abda-s/FSUK-BMS/(list of files, cad)

Other CAD files:
Reference Docs/Community Board Examples/Olin College FSAE - Tractive System Active Light Board.step
Reference Docs/Shared/Community Board Examples/Olin College FSAE - AIL Precharge Board.step
Reference Docs/Community Board Examples/Olin College FSAE - Master Switch Panel Monitor Board.step
