abda-s/FSUK-BMS/BMS-Master/sim/buck/buck_startup.asc

Cb: cap; 100u; Rser=0.3
Cboot: cap; 100n
Cff: cap; 6.8p
Cin: cap; 12u; Rser=3m
Cinx: cap; 100n
Cout: cap; 26u; Rser=3m
Css: cap; 33n
L1: ind; 8.2u; Rser=83m
Lh: ind; 1u
Renb: res; 86.6k
Rent: res; 511k
Rfbb: res; 10k
Rfbt: res; 71.5k
Rh: res; 50m
Rload: res; 6.5
U1: TPS62933F
V1: voltage; PWL(0 0 1m 12)
Named nets: vbat, vin, en, ss, bst, sw, vout, fb, 0
RT open = 500 kHz
12 V battery
Lh, Rh = ~1 m harness (not on PCB)
2x 10uF 50V = ~12uF at 12 V
UVLO 8.0 V on / 7.0 V off
ANR5040T8R2M
47uF 16V = ~26uF at 6.5 V
Vout = 0.8 x (1 + 71.5k/10k) = 6.52 V
TPS62933F buck: 12 V -> 6.5 V, start-up with a 1 A load.  Values = LCSC BOM.csv
.include TPS62933F_LTspice.lib
.options reltol=0.005 trtol=7 method=gear
.save V(vout) V(vin) V(sw) V(ss) V(en) V(bst) V(fb) I(L1) I(Rh)
.tran 0 9m 0 20n
.meas tran t_on WHEN V(vout)=0.1 RISE=1
.meas tran vin_on FIND V(vin) AT=t_on
.meas tran t_90 WHEN V(vout)=5.87 RISE=1
.meas tran vout_max MAX V(vout)
.meas tran il_max MAX I(L1)
.meas tran vout_avg AVG V(vout) FROM 8m TO 9m
.meas tran vout_pp PP V(vout) FROM 8.5m TO 9m
.meas tran il_pp PP I(L1) FROM 8.5m TO 9m
.meas tran pin AVG V(vin)*I(Rh) FROM 8m TO 9m
.meas tran pout AVG V(vout)*V(vout)/6.5 FROM 8m TO 9m
.meas tran eff PARAM pout/pin
