abda-s/FSUK-BMS/(list of files, drawings)

Other design files:
BMS-Master/BMS-Master.PrjPcb
BMS-Master/Sheets/AMS_SDC.SchDoc
BMS-Master/Sheets/CAN.SchDoc
BMS-Master/Sheets/Charger.SchDoc
BMS-Master/Sheets/Connectors.SchDoc
BMS-Master/Sheets/Current_Sense.SchDoc
BMS-Master/Sheets/MCU_STM32.SchDoc
BMS-Master/Sheets/Power.SchDoc
BMS-Master/Sheets/Stack_Interface.SchDoc
BMS-Master/Sheets/Top.SchDoc
BMS-Module/BMS-Module.PrjPcb
BMS-Module/PCB1.PcbDoc
BMS-Module/Sheets/AFE_BQ79616.SchDoc
BMS-Module/Sheets/Balancing.SchDoc
BMS-Module/Sheets/Cell_Sense.SchDoc
BMS-Module/Sheets/Connectors.SchDoc
BMS-Module/Sheets/DaisyChain_Comm.SchDoc
BMS-Module/Sheets/Thermistor_Mux.SchDoc
BMS-Module/Sheets/Top.SchDoc
Reference Docs/BQ796xx BMS/TIDA-010271 Reference Design/TIDA-010271 Altium Source (tidmc07)/BMU0912_Hardware.SchDoc
Reference Docs/BQ796xx BMS/TIDA-010271 Reference Design/TIDA-010271 Altium Source (tidmc07)/BMU_A1_Cell_Network.SchDoc
Reference Docs/BQ796xx BMS/TIDA-010271 Reference Design/TIDA-010271 Altium Source (tidmc07)/BMU_A2_bq79616.SchDoc
Reference Docs/BQ796xx BMS/TIDA-010271 Reference Design/TIDA-010271 Altium Source (tidmc07)/BMU_A2_Cell_Network.SchDoc
Reference Docs/BQ796xx BMS/TIDA-010271 Reference Design/TIDA-010271 Altium Source (tidmc07)/BMU_BQ79616.PcbDoc
Reference Docs/BQ796xx BMS/TIDA-010271 Reference Design/TIDA-010271 Altium Source (tidmc07)/Cap_BMS_Communications.SchDoc
Reference Docs/BQ796xx BMS/TIDA-010271 Reference Design/TIDA-010271 Altium Source (tidmc07)/conn_705550048.PcbLib
Reference Docs/BQ796xx BMS/TIDA-010271 Reference Design/TIDA-010271 Altium Source (tidmc07)/conn_705550048.SchLib
Reference Docs/BQ796xx BMS/TIDA-010271 Reference Design/TIDA-010271 Altium Source (tidmc07)/V2_lib.SchLib
Reference Docs/Master/Power/TPS62933F PSpice Model (SLUM859)/TPS62933F_PSPICE_TRANS/TPS62933F_TRANS.opj
Reference Docs/Master/Power/TPS62933F PSpice Model (SLUM859)/TPS62933F_PSPICE_TRANS/TPS62933FDRL_TRANS.OLB
Reference Docs/Module/TIDA-010271 Reference Design/TIDA-010271 Altium Source (tidmc07)/BMU_A1_bq79616.SchDoc
Reference Docs/Module/TIDA-010271 Reference Design/TIDA-010271 Altium Source (tidmc07)/BMU_BQ79616_coversheet.SchDoc
Reference Docs/Module/TIDA-010271 Reference Design/TIDA-010271 Altium Source (tidmc07)/BMU_EVCC_20230723.PrjPcb
Reference Docs/Module/TIDA-010271 Reference Design/TIDA-010271 Altium Source (tidmc07)/Cell_Simulator.SchDoc
Reference Docs/Module/TIDA-010271 Reference Design/TIDA-010271 Altium Source (tidmc07)/Transf_BMS_Communications.SchDoc
Reference Docs/Module/TIDA-010271 Reference Design/TIDA-010271 Altium Source (tidmc07)/V2_Lib.PcbLib
Reference Docs/Power/TPS62933F PSpice Model (SLUM859)/TPS62933F_PSPICE_TRANS/TPS62933F_TRANS.DSN
