abda-s/FSUK-BMS/(commit log)

2026-09-26 changed the settings to make sure that the Ports will name the nets
    [BMS-Master.PrjPcb]
2026-09-26 Initial commit: BMS-Master and BMS-Module Altium projects + reference docs
    [AFE_BQ79616.SchDoc, BMS-Master.PrjPcb, BMS-Module.PrjPcb, Balancing.SchDoc, CAN.SchDoc, Cell_Sense.SchDoc, Connectors.SchDoc, Current_Sense.SchDoc]
2026-10-01 Add TIDA-010271 Altium reference design source (tidmc07)
    [BMU0912_Hardware.SchDoc, BMU_A1_Cell_Network.SchDoc, BMU_A1_bq79616.SchDoc, BMU_A2_Cell_Network.SchDoc, BMU_A2_bq79616.SchDoc, BMU_BQ79616.PcbDoc, BMU_BQ79616_coversheet.SchDoc, BMU_EVCC_20230723.PrjPcb]
2026-10-02 Organize randoms folder: sort academic papers vs community board examples, annotate links.txt as links.md
2026-10-02 Track images via LFS; add gitignored Open-Source BMS Projects reference folder
2026-10-02 Add Olin College FSAE support-board exports; document 6 more open-source BMS reference repos
    [Olin College FSAE - AIL Precharge Board.step, Olin College FSAE - Master Switch Panel Monitor Board.step, Olin College FSAE - Tractive System Active Light Board.step]
2026-10-02 test file
    [Top.SchDoc]
2026-10-02 added the MCU, this is just for testing git shit
    [MCU_STM32.SchDoc]
2026-10-02 added "Text" in Top
    [Top.SchDoc]
2026-10-02 testing the lfs lock shit
    [CAN.SchDoc, MCU_STM32.SchDoc, Power.SchDoc]
2026-10-02 Add OutputJob files for one-click schematic PDF export, modeled on TI's reference design
    [BMS-Master.PrjPcb, BMS-Module.PrjPcb]
2026-10-02 Generate BMS-Master schematic PDF via OutputJob
    [BMS-Master.PrjPcb]
2026-10-02 added the job that generates the PDF schematic files
    [BMS-Module.PrjPcb]
2026-10-02 added text
    [Top.SchDoc]
2026-10-02 Add STM32G474 MCU selection rationale and block diagram for BMS-Master
2026-10-02 Consolidate design docs into per-board README.md, fix dangling chat-history citation
2026-10-02 Trim narrative padding from BMS-Master README, keep it factual
2026-10-03 Added the STM32G474REV with the capacitors and the crystal
    [MCU_STM32.SchDoc]
2026-10-03 Organize STM32G474 datasheet into Reference Docs, link from MCU selection doc
2026-10-03 Added the basic setup for the BQ79600, we still need to do the diff pair isolation
    [Stack_Interface.SchDoc]
2026-10-03 updated the schematic pdf
2026-10-05 sch(master): Add the final power and conf pins schematics MCU_STM32.SchDoc
    [MCU_STM32.SchDoc]
2026-10-05 docs(master): updated the schematics PDF
2026-10-06 docs(master): drop standby-current and ESD as CAN transceiver requirements
2026-10-06 docs(master): confirm Hall-effect current sensor, drop op-amp as MCU factor
2026-10-06 docs(master): clarify ADC requirement drives current limit/fault logic, not just telemetry
2026-10-06 docs(master): CAN transceiver v1=TCAN1042V-Q1 (stock/hand-solder), v2 target=TCAN1462V-Q1
2026-10-06 sch(master): finish the initial design of the CAN CAN.SchDoc
    [CAN.SchDoc, Top.SchDoc]
2026-10-06 doc(master): update the schematic PDF
2026-10-06 ref: organize LEM DHAB S124 current sensor datasheet; link from MCU selection sources
2026-10-07 fix(master): fix resistor values CAN.SchDoc
    [CAN.SchDoc, Top.SchDoc]
2026-10-08 fix(master): fixed the CAN shit CAN.SchDoc
    [CAN.SchDoc]
2026-10-08 sch(master): Add the isolation part to the COM ports Stack_Interface.SchDoc
    [Stack_Interface.SchDoc]
2026-10-08 fix(master): idk maybe changed some settings
    [BMS-Master.PrjPcb]
2026-10-09 fix(master): Add some new notes that needs to be implemented
    [CAN.SchDoc]
2026-10-09 sch(master): Add some notes to how to do the isolation correctly cuz now it's not isolated
    [Stack_Interface.SchDoc]
2026-10-14 docs(master): add daisy-chain transformer selection (SM91502ALE)
    - Document transformer choice against TI SLVAEP4 validated list and
    FSG EV 1.2.1 / EV 4.3.6, comparing SM91502AL, HMU1228NL, HM2147NL.
    - ref: organize BMS transformer (Bourns SM91502AL, Pulse HMU1228NL,
    Pulse BM101, CND-tek CB0603S), Bourns SRF0703 choke and TDSEMI
    PESD5V0L2BT ESD datasheets.
2026-10-15 ref(master): Add datasheets for current sensors
2026-10-15 ref: upload high voltage cables datasheet
2026-10-15 sch(module): add balancing and daisy-chain circuits
    Balancing.SchDoc and DaisyChain_Comm.SchDoc, with the matching
    hookup in AFE_BQ79616.SchDoc.
2026-10-15 sch(module): add cell-sense input filters to Cell_Sense.SchDoc
    Work in progress - filter values not final.
2026-10-15 pcb(module): add PCB1.PcbDoc and register new docs in project
    Also adds Choke.SCHLIB to the project, saves the SMW0530H library
    update settings and drops unused export outputs.
2026-10-15 docs(master): add current sensor selection (DHAB S/124)
    - Document DHAB S/124 against FSG/FSUK rules (EV 5.8, T 11.9, EV 1.2.1),
    how it works, ADC interface, fault detection, accuracy, isolation via
    the 600 V cable insulation, mounting, alternatives and open items.
    - Add explanatory SVG diagrams under BMS-Master/docs/current-sensor/.
    - ref: move TS cable datasheet to Reference Docs/TS Cable/.
2026-10-15 sch(master): add DHAB S/124 current sense front end Current_Sense.SchDoc
    - 12k/18k 0.1% dividers + 100 nF ADC caps for HI, LO and sensor supply.
    - 22 nF C_L on HI/LO (DHAB datasheet: 1-100 nF output load), 47 nF on +5.
    - Harnesses ISENSE_SENSOR (HI, LO) and ISENSE_ADC (HI, LO, SUPPLY);
    nets renamed to ISENSE_* convention.
    - Design notes on the sheet explaining each block and PCB placement.
2026-10-15 ref: highlight 300 V UL rating in DHAB S/124 datasheet
    Marks the "primary involved potential 300 V" line that the isolation
    argument in BMS-Master/README.md addresses.
2026-10-17 sch(master): add isolated charger STOP interface Charger.SchDoc
    PC817 opto drives the Manzanita Reg Bus BLACK line, fail-safe (10k
    pull-up stops the charger unless CHG_EN is high). Nets renamed to
    CHG_EN, REGBUS_STOP, +5V_REGBUS, GND_REGBUS, with short notes.
    README: charger interface section; RJ12 jack must be ordered online.
    Adds PC817 datasheet and the charger owner's manual.
2026-10-17 sch(master): add AMS_OK 12 V output to the SDC AMS_SDC.SchDoc
    Two-MOSFET high-side driver (AO3400A level shift, AO3401A switch)
    gives 12 V on AMS_OK while the MCU says OK and 0 V on fault, reset,
    power loss, broken wire or short. Drives the SDC board relay coil
    (G5Q-14-DC12) through a 100 mA PTC; no series resistor.
    README: AMS_OK section with resistor calculations and sources,
    external watchdog moved to v2, IWDG firmware item.
    Adds MOSFET, relay, fuse and watchdog datasheets and app notes.
2026-10-17 sch(master): transformer same-part note, update block diagram
    Stack_Interface.SchDoc: note that the transformer must be the same part
    number as on BMS-Module (TI BQ79600 requirement). Updated block diagram.
2026-10-17 docs(master): update to-do, AMS_OK and isolation notes
    - AMS_OK also opens the charging SDC; schematic image replaces the
    text drawing; flyback diode and RT2 notes removed
    - Charger opto PC817B checked against EV 1.2.1 (passes, kept) and
    EV 4.3.6 creepage note
    - Transformer insulation grades explained (Functional vs Basic) and
    what to ask FSUK before ordering
    - To-do: Top.SchDoc, charger opto and transformer note done
2026-10-18 sch(master): add balancing master switch MCU_STM32.SchDoc
    ALPS SSSS811101 slide switch: common to GND, pin 3 to BAL_EN_N with a
    10k pull-up to 3V3 and 100 nF to GND. Active low, so off, reset or a
    failed joint all read as balancing off.
    README: balancing switch section (what it does, why each part), to-do
    updated. Adds the switch datasheet.
2026-10-21 docs(master): power budget, TPS62933F buck design and LTspice start-up sim
    Power tree and budget, buck BOM and UVLO, LTspice model patches, schematic,
    results and charts. Large sim outputs (.raw, data CSV, chart gallery) are
    gitignored.
2026-10-21 sch(master): rename +5 to +5V, AMS_OK 2K2 output resistor
2026-10-21 docs: add power reference docs (TPS6293x, LMR51430, SMBJ16A, WEBENCH, TI model), BSS84
2026-10-21 sch(master): TPS62933F 12 V to 6 V buck on Power.SchDoc
2026-10-22 docs(master): add buck schematic image from Power.SchDoc
2026-10-22 docs(master): 6.5 V buck, LDO selection, LV input protection, full buck sims
    - Buck raised to 6.52 V (R_FBT 71.5k) so the 5 V LDO gets the 1.5 V
    headroom its datasheet specs assume; power budget recomputed.
    - LDO selection: TI TLV76150DCYR / TLV76133DCYR (SOT-223), with the
    requirements, all 16 candidates and why each was rejected, PSRR explainer.
    - LV input protection: 1 A slow-blow fuse, SS34 reverse diode, SMBJ16A TVS.
    - Simulations: load step, 9/11/16 V input, hot-plug with/without bulk cap
    and TVS; 9 V loop oscillation found, fixed by a second 47 uF in sim.
    - Charts regenerated; Altium images for buck, LDOs and input protection.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
2026-10-22 sch(master): input protection, 6.5 V buck and TLV761 LDOs on Power.SchDoc
2026-10-22 docs: LDO candidate datasheets; buck BOM R_FBT 71.5k
2026-10-22 docs(master): regenerate schematic PDF, one page per sheet
    OutJob: FitSCHPrintSizeToDoc=1 so each PDF page takes its sheet's size.
    Before, every sheet was printed 1:1 onto A4 and the larger sheets (CAN)
    were tiled across two pages. Now 9 sheets = 9 pages.
2026-10-23 sch(master): connectors J1-J4, CAN as one reused channel, MCU ports, Top wired
    - Connectors.SchDoc: J1 Micro-Fit 2x8, J2 Micro-Fit 2-pin (COMH), J3 RJ12
    DS1133-S60BPX, J4 SWD; pins wired to ports, SWD as a harness
    - CAN.SchDoc: single TCAN1042 channel placed twice on Top (CAN1, CAN2);
    bus side as plain CAN_H/CAN_L ports, MCU side CAN_MCU harness
    - Top.SchDoc: sheet symbols named, Charger/AMS_SDC file names fixed,
    all sheets wired including CONN and MCU
    - MCU_STM32.SchDoc: ports and harnesses for every Top link (pins not
    assigned yet)
    - README: connector parts and photos, schematic structure section,
    STM32 pin proposal, updated to-do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
2026-10-23 docs(master): regenerate schematic PDF
2026-10-23 ref: split Reference Docs into Shared/Master/Module, add reading guide; root README
    - Reference Docs: BQ79600 docs to Master, BQ79616 docs and TIDA-010271 to
    Module, daisy-chain/system docs, transformers, rules and other teams'
    work to Shared; README with reading order and folder index
    - Root README: system overview and block diagram (Docs/system-block-diagram.svg)
    - Paths updated in BMS-Master/README.md, .gitignore and the buck model
2026-10-23 docs(master): reorganise README, new block diagram, part photos and schematic images
    - README: contents list, sections grouped by board area, progress moved to
    the end, wording simplified, outdated notes fixed (RJ12, LV_IN, J1 pins,
    watchdog v2), STM32 pin proposal removed
    - Block diagram redrawn as docs/block-diagram.svg (buck 6.5 V + LDOs,
    AMS_OK instead of relay, watchdog v2); old PNG removed
    - Part photos (docs/parts): DHAB S/124, Manzanita charger, SM91502ALE,
    SSSS811101
    - Schematic captures from Altium (docs/sch): MCU, balancing switch, stack
    interface, CAN, current sense, charger, connectors
